Lycans-Training-27/Team-02-PADA/Mechanical/CAD/Electrical Components/ESC/LittleBee-Spring 30A.JPG

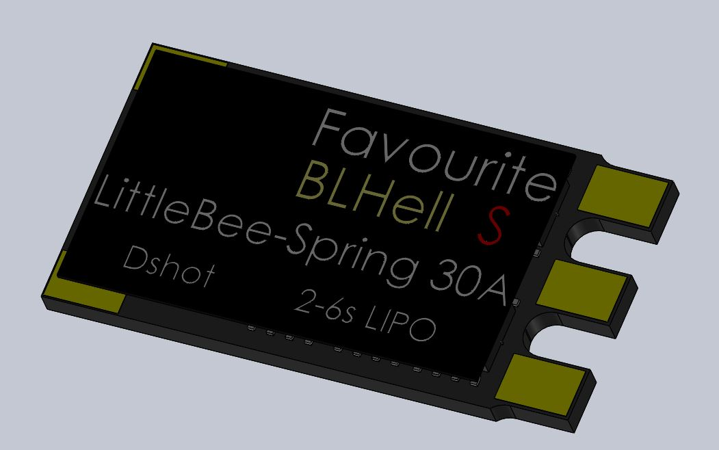
Mechanical/CAD/Electrical Components/ESC/LittleBee-Spring 30A.JPG
