Lycans-Training-27/Team-02-PADA/Mechanical/CAD/Electrical Components/Flight Controller/Автопилот Matek H743-WING V2(V3).PNG

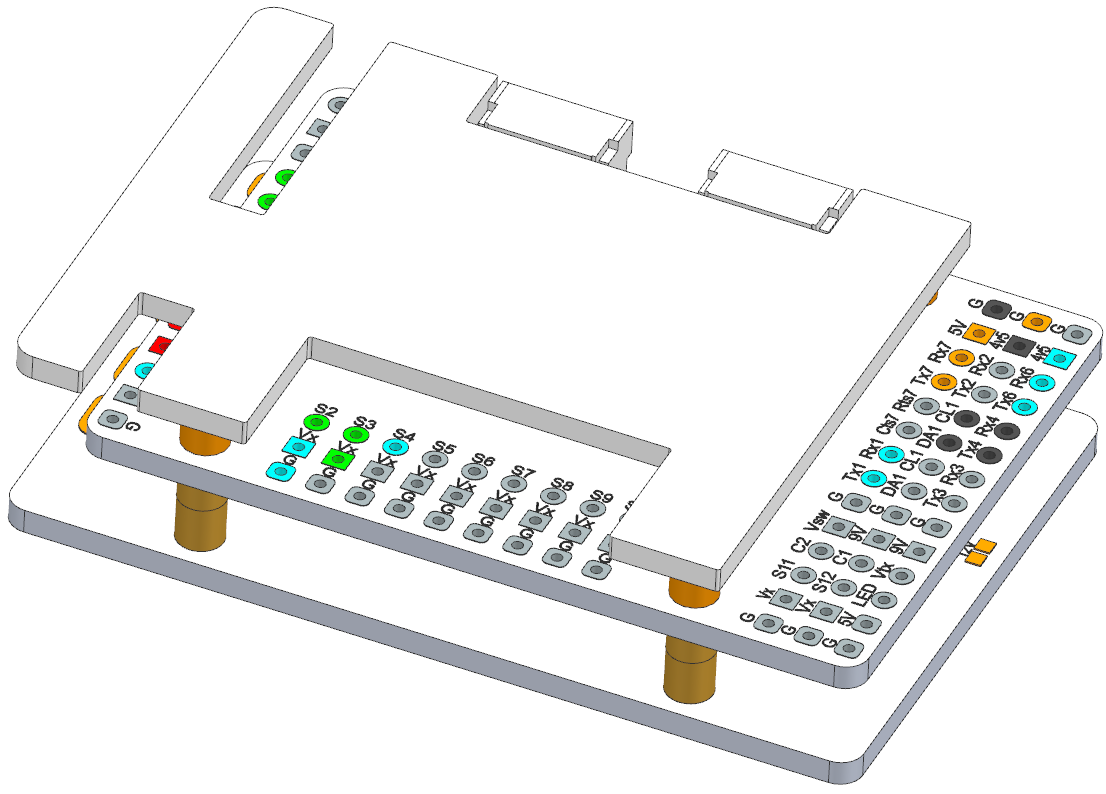
Mechanical/CAD/Electrical Components/Flight Controller/Автопилот Matek H743-WING V2(V3).PNG
