Lycans-Training-27/Team-02-PADA/Mechanical/CAD/Electrical Components/Motor/1RENDER.jpg

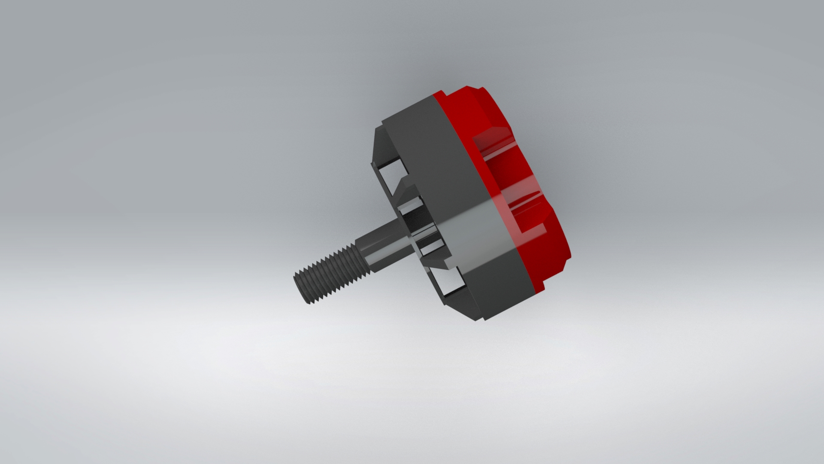
Mechanical/CAD/Electrical Components/Motor/1RENDER.jpg
