Lycans-Training-27/Team-02-PADA/Mechanical/CAD/Electrical Components/Propeller/98.jpg

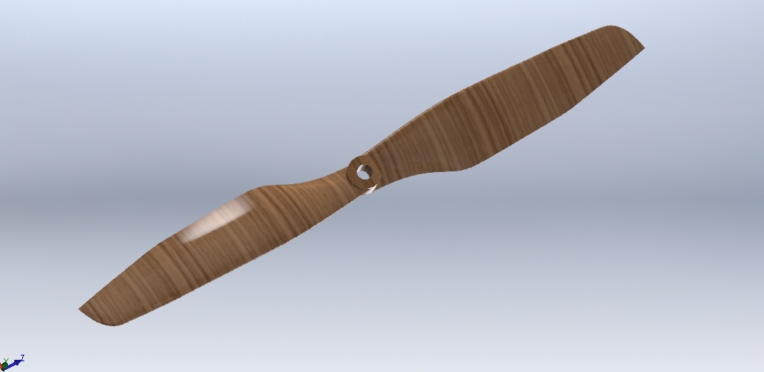
Mechanical/CAD/Electrical Components/Propeller/98.jpg
