Lycans-Training-27/Team-02-PADA/Mechanical/CAD/Electrical Components/Propeller/109.jpg

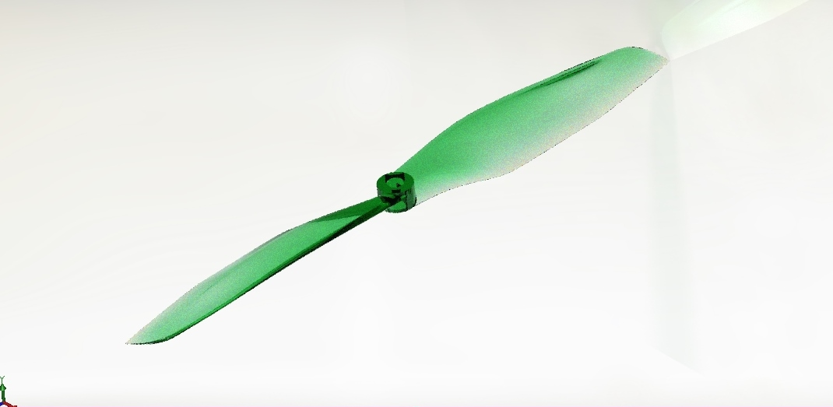
Mechanical/CAD/Electrical Components/Propeller/109.jpg
