Lycans-Training-27/Team-02-PADA/Mechanical/CAD/Electrical Components/Propeller/Renderings/8x4.5 - Rendu 2.JPG

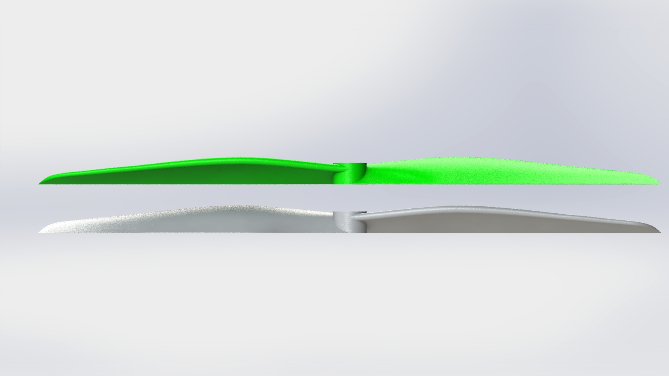
Mechanical/CAD/Electrical Components/Propeller/Renderings/8x4.5 - Rendu 2.JPG
