Lycans-Training-27/Team-02-PADA/Mechanical/CAD/Electrical Components/Propeller/Screenshot 2025-04-27 175526.png

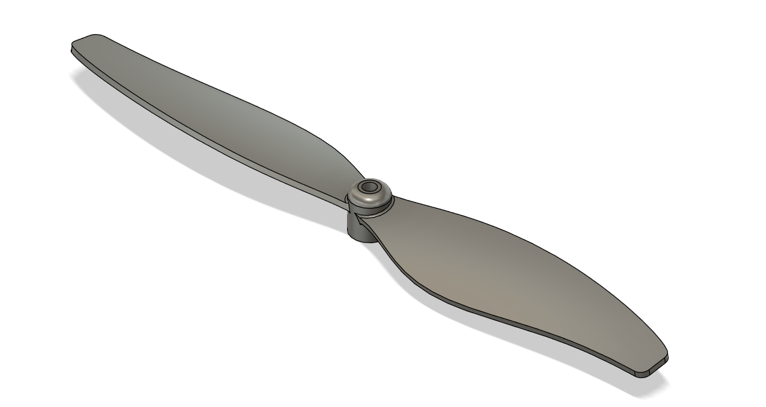
Mechanical/CAD/Electrical Components/Propeller/Screenshot 2025-04-27 175526.png
