Lycans-Training-27/Team-02-PADA/Mechanical/CAD/Electrical Components/Radio/8b44bde3-e0da-4845-a45c-0b3df0e6323b.PNG

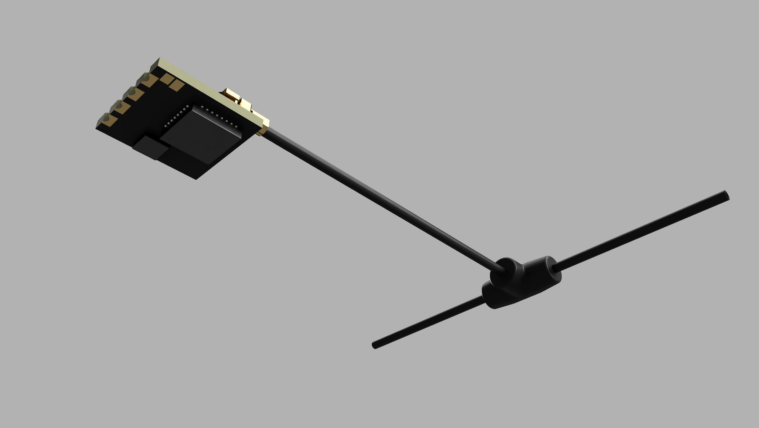
Mechanical/CAD/Electrical Components/Radio/8b44bde3-e0da-4845-a45c-0b3df0e6323b.PNG
