Lycans-Training-27/Team-02-PADA/Mechanical/CAD/Electrical Components/Radio/BetaFPV_M03_V1.1_2024-Apr-02_08-13-07AM-000_CustomizedView17843087987.png

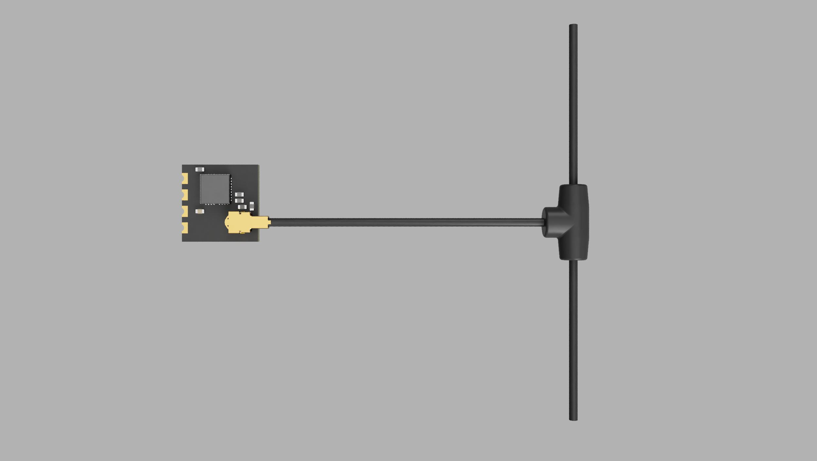
Mechanical/CAD/Electrical Components/Radio/BetaFPV_M03_V1.1_2024-Apr-02_08-13-07AM-000_CustomizedView17843087987.png
