Lycans-Training-27/Team-02-PADA/Mechanical/CAD/Electrical Components/Radio/Happymodel_EP1_Simp_2024-Apr-02_08-42-46AM-000_CustomizedView5246592539.png

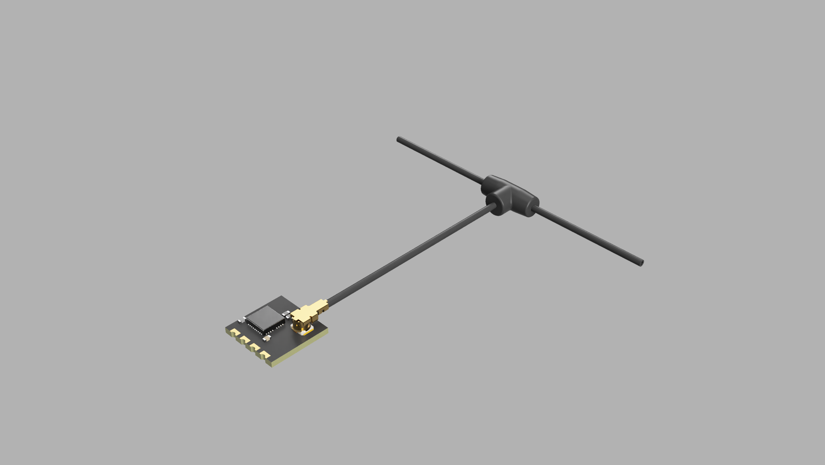
Mechanical/CAD/Electrical Components/Radio/Happymodel_EP1_Simp_2024-Apr-02_08-42-46AM-000_CustomizedView5246592539.png
