Lycans-Training-27/Team-02-PADA/Mechanical/CAD/Aircraft.SLDASM

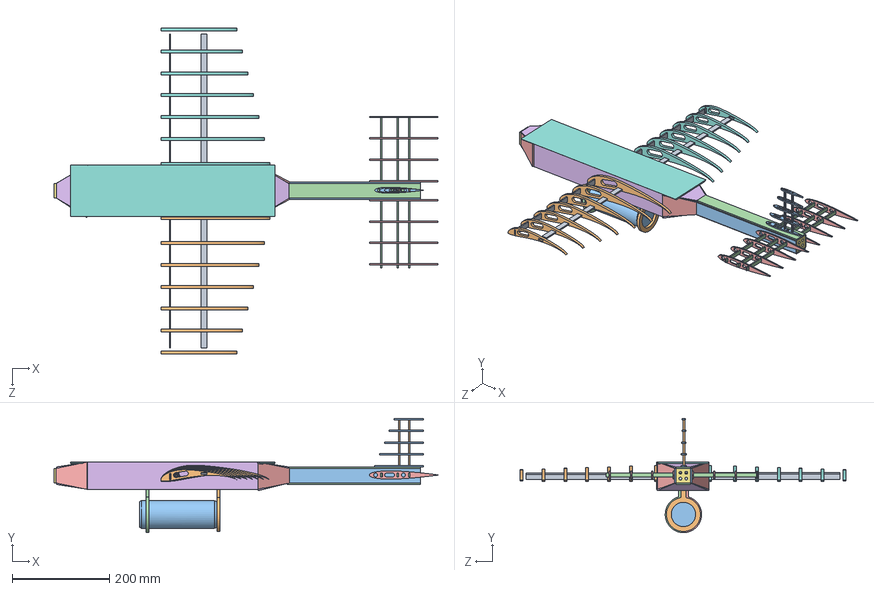
[picture p68: CAD file, 2026-09-13]
Mechanical/CAD/Aircraft.SLDASM
789.6 x 235.1 x 670.0 mm
HT
HT_Spur x 3
VT
VT_Spur x 2
Fuselage-Bulkhead x 6
Fuselage-Panel
Nose-Bulkhead x 6
Nose-Panel x 4
Nose-Panel-Side x 4
Tail-Panel x 2
Tail-Panel-Side x 2
Left-Ribs
Wing-Spar x 4
Right-Ribs
Fuselage-Panel-Right
Fuselage-Panel-Left
Fixed-Mechanism-Arm
Movable-Mechanism-Arm
Pepsi-can
Back-Support
Fuselage-Panel-Bottom
