Lycans-Training-27/Team-02-PADA/Mechanical/CAD/Aircraft+Hardware.SLDASM

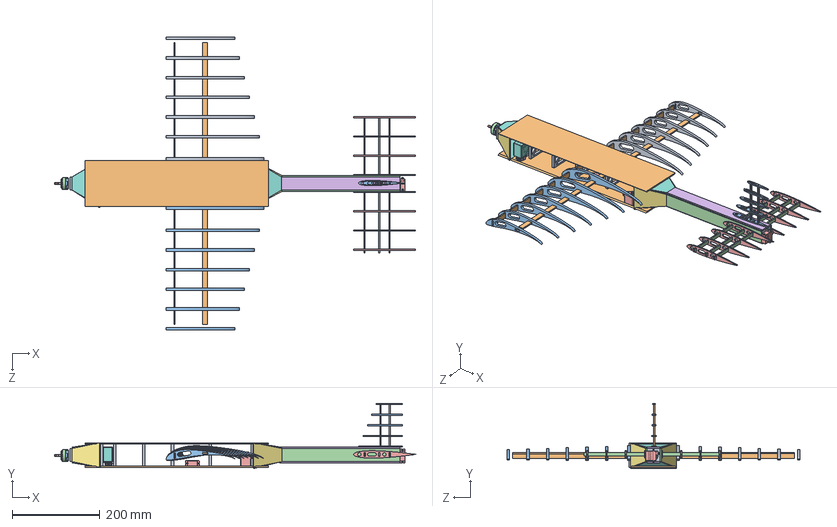
[picture p69: CAD file, 2026-09-13]
Mechanical/CAD/Aircraft+Hardware.SLDASM
825.2 x 148.9 x 670.0 mm
HT
HT_Spur x 3
VT
VT_Spur x 2
Fuselage-Bulkhead x 6
tattu 1300MHa 3s LiPo
JST XHP-4
XT60 Buchse
shaft
motor lower part
motor upper part
Fuselage-Panel x 2
Nose-Bulkhead x 6
Nose-Panel x 4
Nose-Panel-Side x 4
Tail-Panel x 2
MG90S x 5
Tail-Panel-Side x 2
Left-Ribs
Wing-Spar x 4
Right-Ribs
