Lycans-Training-27/Team-02-PADA/Mechanical/CAD/Electrical Components/Battery/TATTU 1300mah 3s.SLDASM

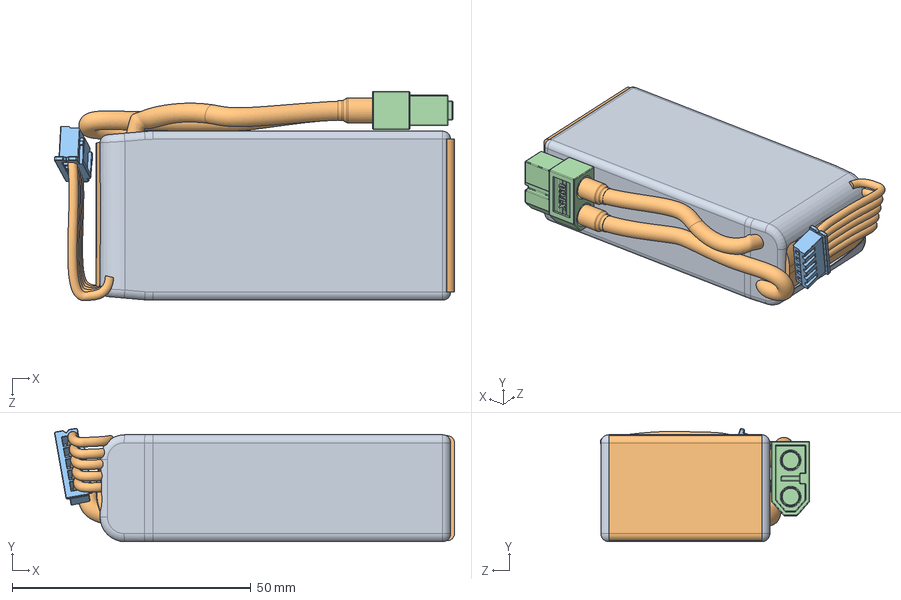
[picture p70: CAD file, 2026-09-13]
Mechanical/CAD/Electrical Components/Battery/TATTU 1300mah 3s.SLDASM
83.7 x 23.7 x 43.8 mm
tattu 1300MHa 3s LiPo
JST XHP-4
XT60 Buchse
