Lycans-Training-27/Team-02-PADA/Mechanical/CAD/Wing/Left-Wing.SLDASM

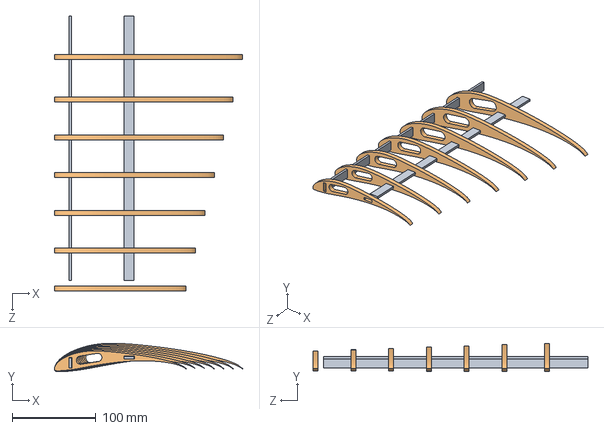
[picture p71: CAD file, 2026-09-13]
Mechanical/CAD/Wing/Left-Wing.SLDASM
224.0 x 33.8 x 327.5 mm
Left-Ribs
Wing-Spar x 2
