Lycans-Training-27/Team-02-PADA/Mechanical/CAD/Fuselage/Fuselage.SLDASM

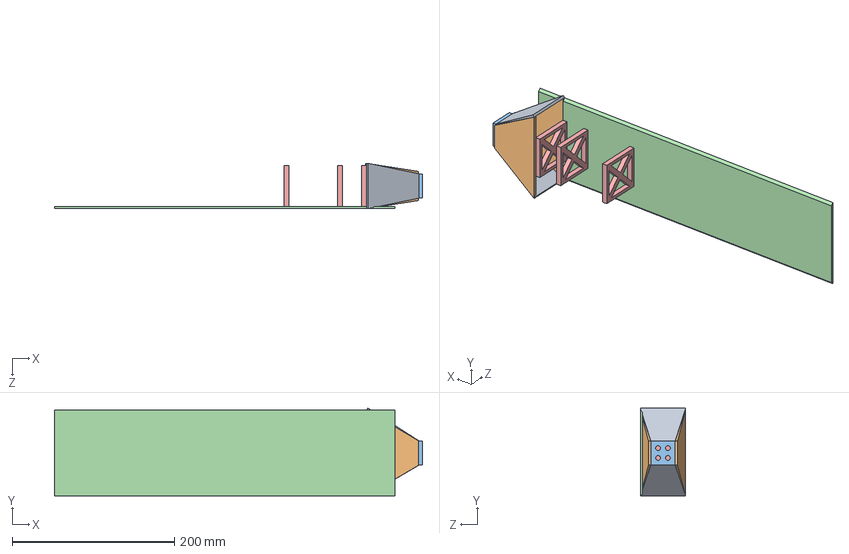
[picture p72: CAD file, 2026-09-13]
Mechanical/CAD/Fuselage/Fuselage.SLDASM
454.0 x 108.5 x 56.0 mm
Fuselage-Bulkhead x 3
Fuselage-Panel
Nose-Bulkhead
Nose-Panel x 2
Nose-Panel-Side x 2
