Lycans-Training-27/Team-02-PADA/Mechanical/CAD/Electrical Components/Battery/JST XHP-4.sldprt

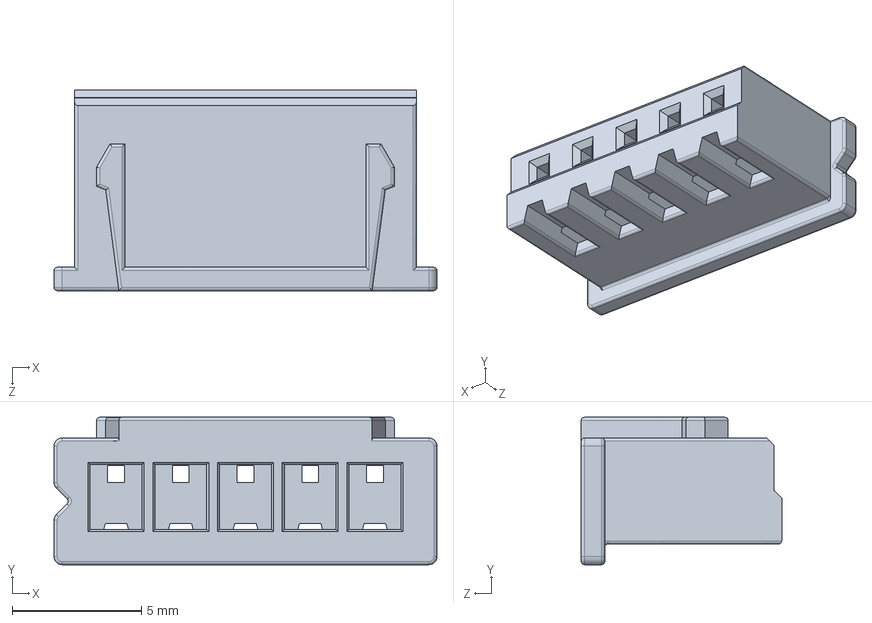
[picture p73: CAD file, 2026-09-13]
Mechanical/CAD/Electrical Components/Battery/JST XHP-4.sldprt
14.8 x 5.70 x 7.75 mm
