Lycans-Training-27/Team-02-PADA/Mechanical/CAD/Electrical Components/ESC/LittleBee-Spring30A.STEP

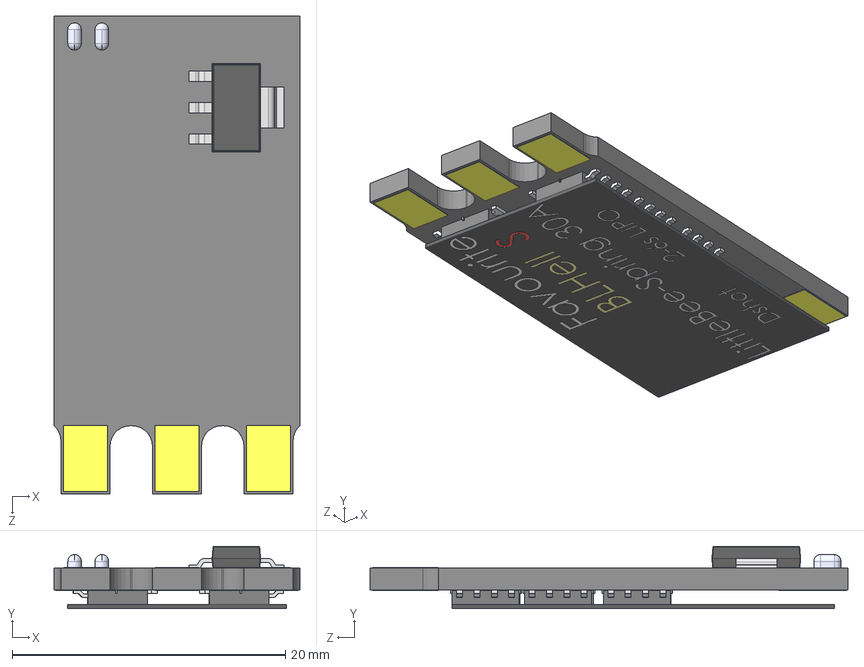
[picture p74: CAD file, 2026-09-13]
Mechanical/CAD/Electrical Components/ESC/LittleBee-Spring30A.STEP
18.0 x 4.57 x 35.0 mm
