Lycans-Training-27/Team-02-PADA/Mechanical/CAD/Electrical Components/Flight Controller/Автопилот Matek H743-WING V2(V3).stp

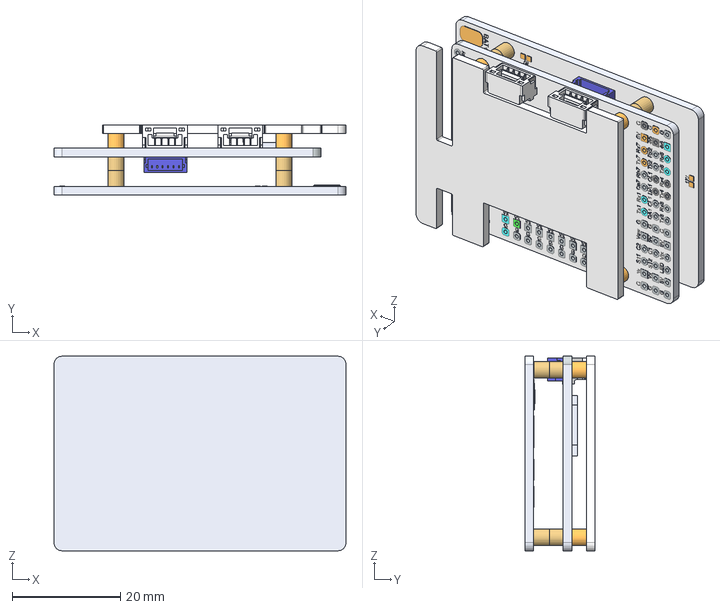
[picture p75: CAD file, 2026-09-13]
Mechanical/CAD/Electrical Components/Flight Controller/Автопилот Matek H743-WING V2(V3).stp
54.0 x 13.0 x 36.0 mm
