Lycans-Training-27/Team-02-PADA/Mechanical/CAD/Electrical Components/GPS/Mateksys M10Q-5883.step

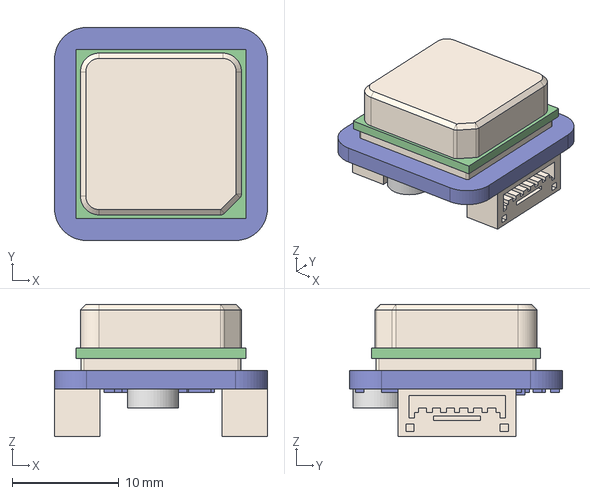
[picture p76: CAD file, 2026-09-13]
Mechanical/CAD/Electrical Components/GPS/Mateksys M10Q-5883.step
20.0 x 20.0 x 12.4 mm
