Lycans-Training-27/Team-02-PADA/Mechanical/CAD/Electrical Components/Motor/motor upper part.SLDPRT

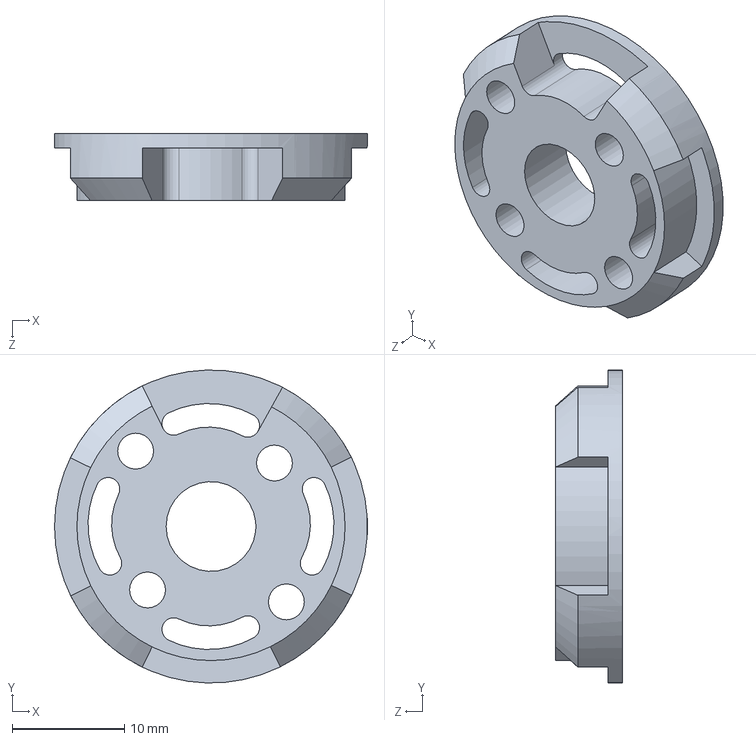
[picture p77: CAD file, 2026-09-13]
Mechanical/CAD/Electrical Components/Motor/motor upper part.SLDPRT
27.9 x 27.9 x 6.00 mm
