Lycans-Training-27/Team-02-PADA/Mechanical/CAD/Electrical Components/Propeller/Gemfan 3in 2blade.stl

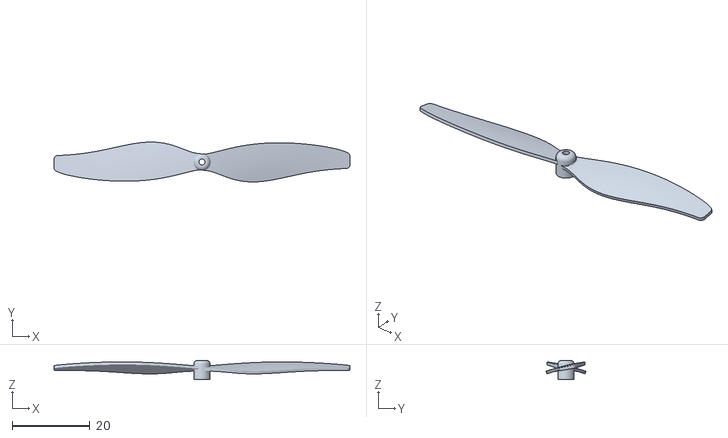
[picture p78: CAD file, 2026-09-13]
Mechanical/CAD/Electrical Components/Propeller/Gemfan 3in 2blade.stl
76.3 x 10.3 x 5.00
