Lycans-Training-27/Team-02-PADA/Mechanical/CAD/Electrical Components/Radio/Happymodel EP1 Simp.step

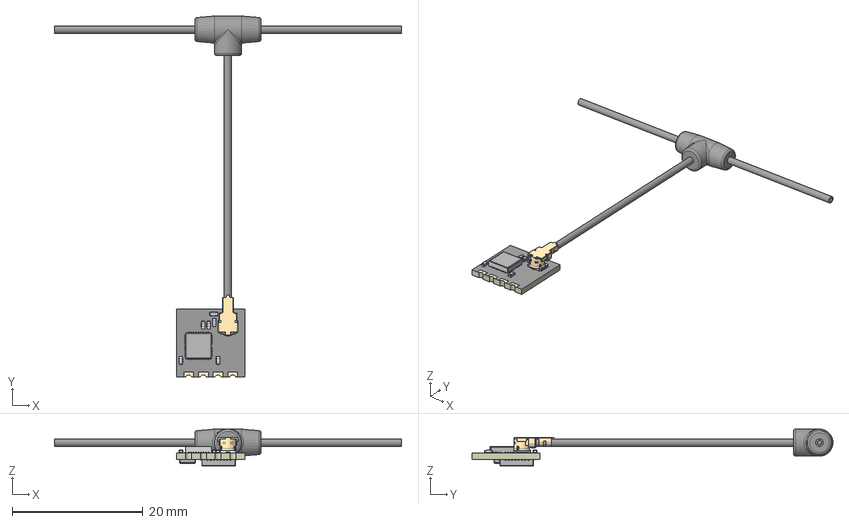
[picture p79: CAD file, 2026-09-13]
Mechanical/CAD/Electrical Components/Radio/Happymodel EP1 Simp.step
53.2 x 55.3 x 5.65 mm
Dipole T Antenna
UFL IPEX Connector v1
u.Fl Antenna Connector - 523-A-1JB v1
HM EP1
