Lycans-Training-27/Team-02-PADA/Mechanical/CAD/Electrical Components/Servo/MG90S_step.step

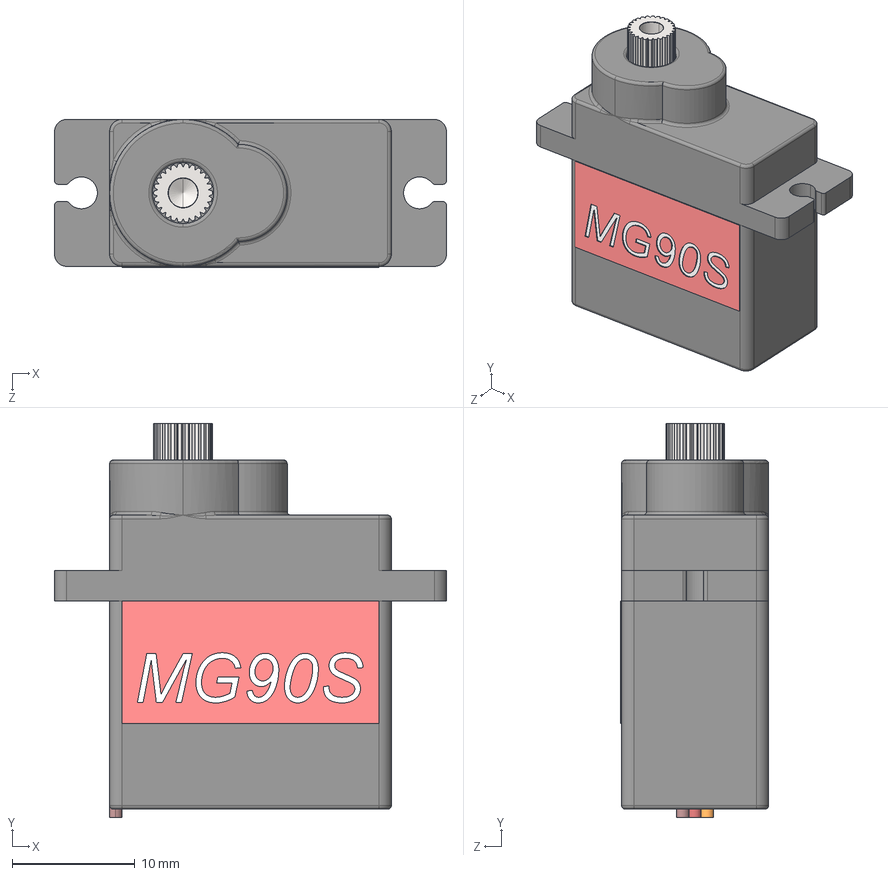
[picture p80: CAD file, 2026-09-13]
Mechanical/CAD/Electrical Components/Servo/MG90S_step.step
32.0 x 32.2 x 12.1 mm
