Lycans-Training-27/Team-02-PADA/Mechanical/CAD/Fuselage/Fuselage-Panel-Right.SLDPRT

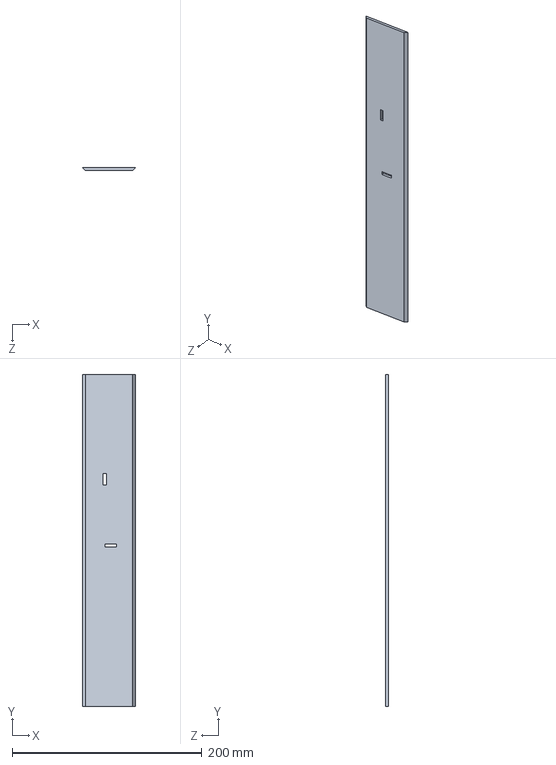
[picture p81: CAD file, 2026-09-13]
Mechanical/CAD/Fuselage/Fuselage-Panel-Right.SLDPRT
56.0 x 350.0 x 3.00 mm
