Lycans-Training-27/Team-02-PADA/Mechanical/CAD/Nose/Nose-Panel.SLDPRT

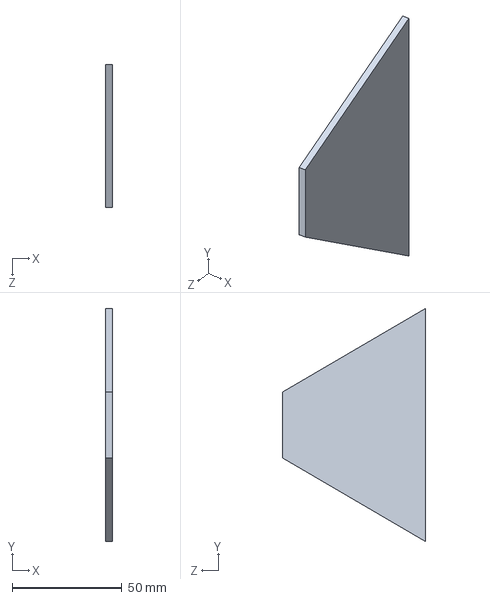
[picture p82: CAD file, 2026-09-13]
Mechanical/CAD/Nose/Nose-Panel.SLDPRT
3.00 x 106.0 x 65.0 mm
