Lycans-Training-27/Team-02-PADA/Mechanical/CAD/Release Mechanism/Movable-Mechanism-Arm.SLDPRT

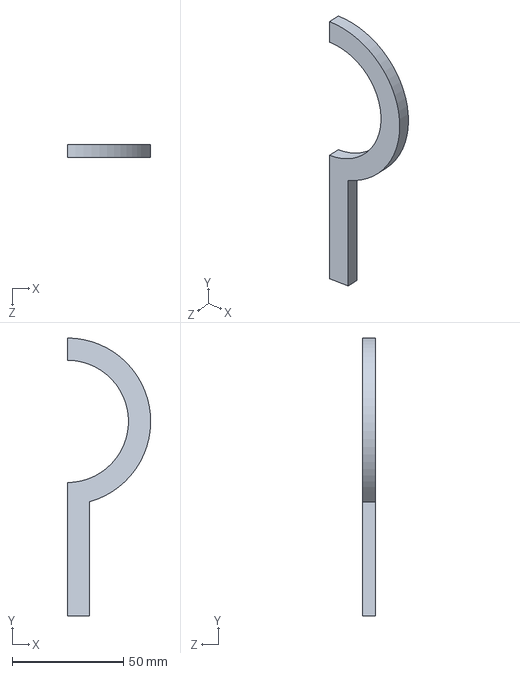
[picture p83: CAD file, 2026-09-13]
Mechanical/CAD/Release Mechanism/Movable-Mechanism-Arm.SLDPRT
37.5 x 125.0 x 6.00 mm
