Lycans-Training-27/Team-02-PADA/Mechanical/CAD/Tail/VT_Spur.SLDPRT

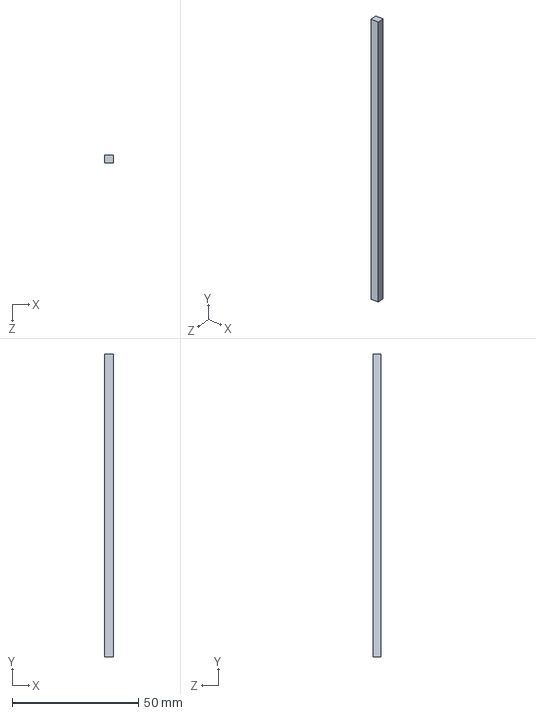
[picture p84: CAD file, 2026-09-13]
Mechanical/CAD/Tail/VT_Spur.SLDPRT
3.50 x 120.0 x 3.00 mm
