Lycans-Training-27/Team-02-PADA/Mechanical/CAD/Team2-Lycans/Fuselage-Panel-Bottom.DXF

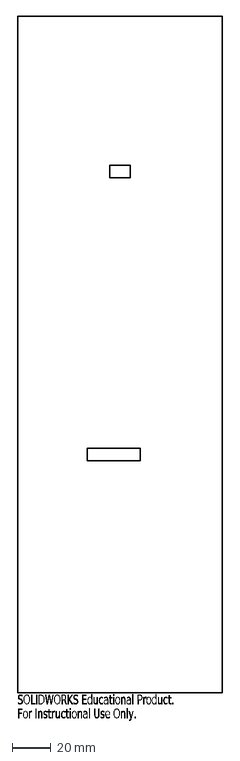
[picture p85: CAD file, 2026-09-13]
Mechanical/CAD/Team2-Lycans/Fuselage-Panel-Bottom.DXF
SOLIDWORKS Educational Product.
For Instructional Use Only.
