Lycans-Training-27/Team-02-PADA/Mechanical/CAD/Wing/Right-Ribs.SLDPRT

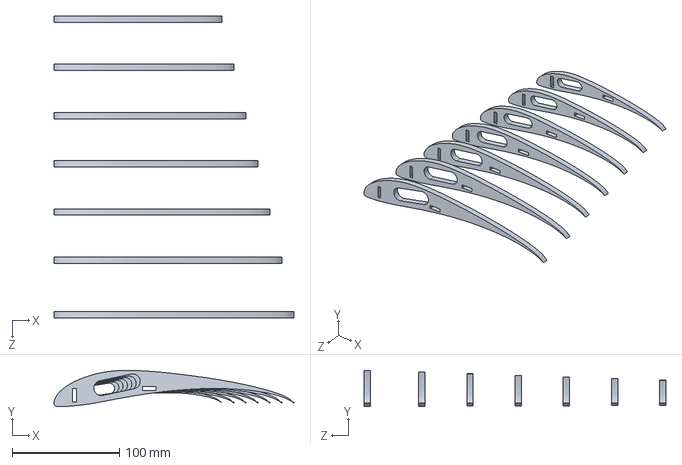
[picture p86: CAD file, 2026-09-13]
Mechanical/CAD/Wing/Right-Ribs.SLDPRT
224.0 x 33.8 x 282.0 mm
