Lycans-Training-27/Team-02-PADA/Mechanical/CAD/Electrical Components/Motor/motor lower part.SLDPRT

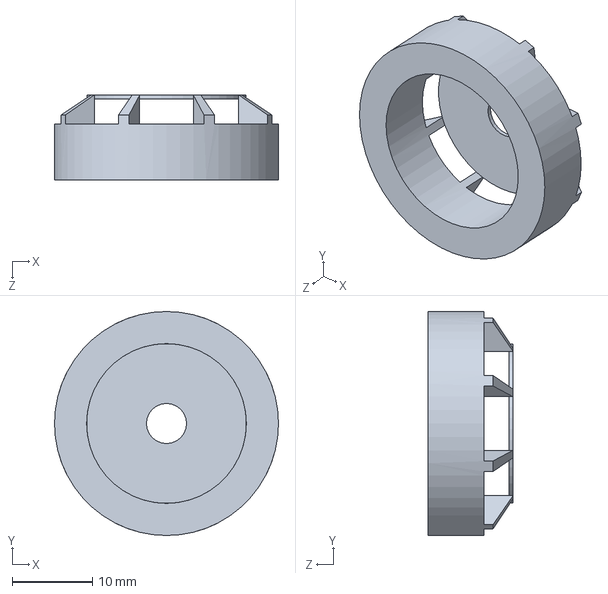
[picture p87: CAD file, 2026-09-13]
Mechanical/CAD/Electrical Components/Motor/motor lower part.SLDPRT
27.9 x 27.9 x 10.6 mm
