Lycans-Training-27/Team-02-PADA/Mechanical/CAD/Electrical Components/Propeller/PROPELLER - 8x4.5 CW.STEP

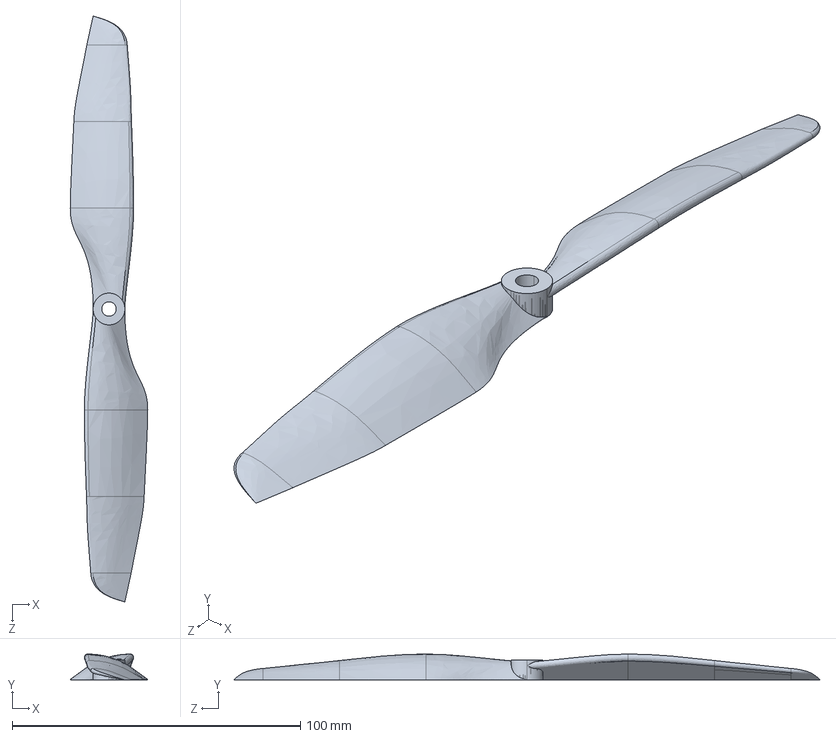
[picture p88: CAD file, 2026-09-13]
Mechanical/CAD/Electrical Components/Propeller/PROPELLER - 8x4.5 CW.STEP
26.9 x 9.01 x 203.2 mm
