Lycans-Training-27/Team-02-PADA/Mechanical/CAD/Fuselage/Fuselage-Bulkhead.SLDPRT

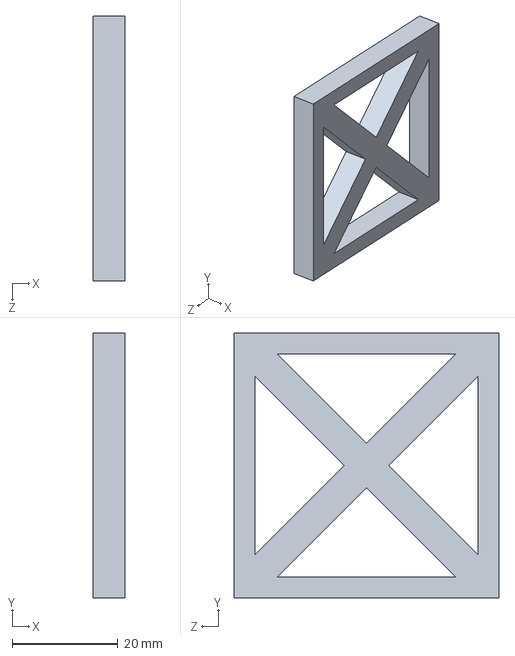
[picture p89: CAD file, 2026-09-13]
Mechanical/CAD/Fuselage/Fuselage-Bulkhead.SLDPRT
6.00 x 50.0 x 50.0 mm
