Lycans-Training-27/Team-02-PADA/Mechanical/CAD/Nose/Nose-Panel-Side.SLDPRT

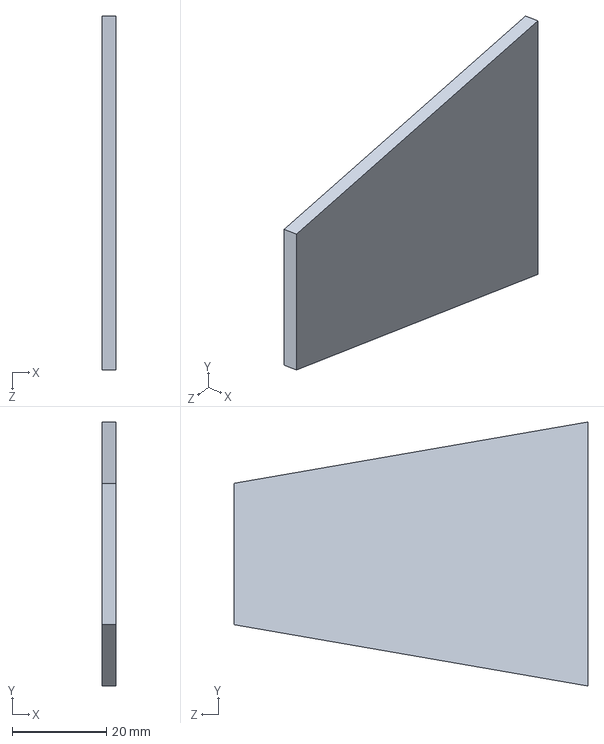
[picture p90: CAD file, 2026-09-13]
Mechanical/CAD/Nose/Nose-Panel-Side.SLDPRT
3.00 x 56.0 x 75.0 mm
