Lycans-Training-27/Team-02-PADA/Mechanical/CAD/Release Mechanism/Pepsi-can.SLDPRT

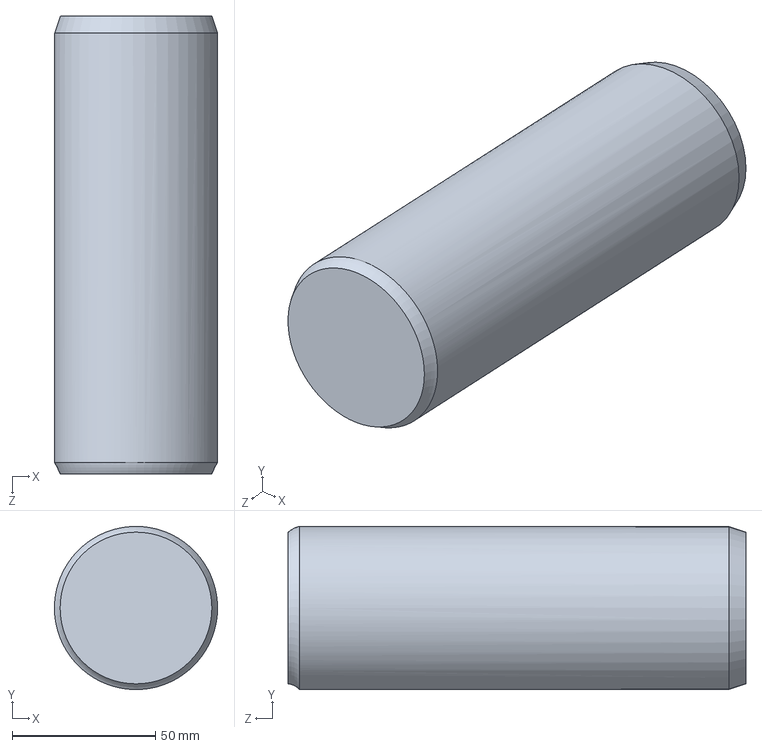
[picture p91: CAD file, 2026-09-13]
Mechanical/CAD/Release Mechanism/Pepsi-can.SLDPRT
57.0 x 57.0 x 160.0 mm
