Lycans-Training-27/Team-02-PADA/Mechanical/CAD/Tail/HT.SLDPRT

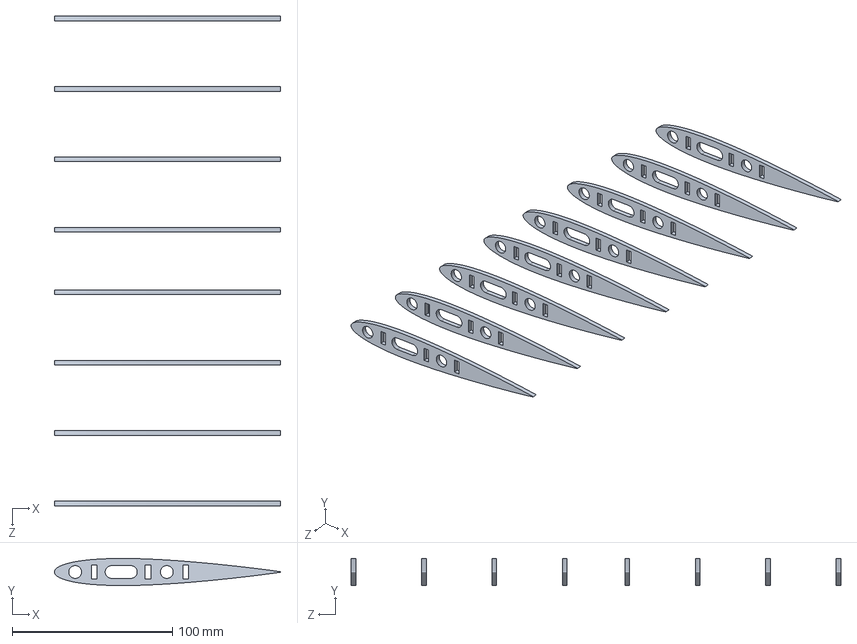
[picture p92: CAD file, 2026-09-13]
Mechanical/CAD/Tail/HT.SLDPRT
141.3 x 17.0 x 306.0 mm
