Lycans-Training-27/Team-02-PADA/Mechanical/CAD/Electrical Components/Battery/XT60 Buchse.SLDPRT

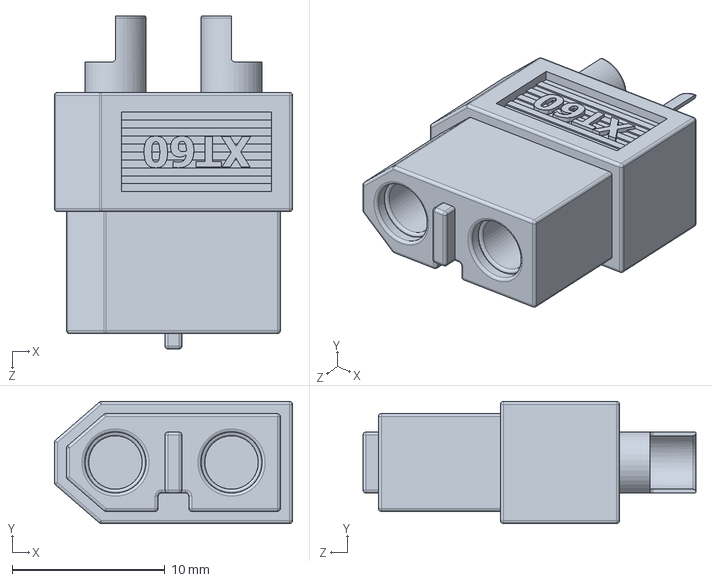
[picture p94: CAD file, 2026-09-13]
Mechanical/CAD/Electrical Components/Battery/XT60 Buchse.SLDPRT
15.6 x 8.00 x 21.8 mm
