Lycans-Training-27/Team-02-PADA/Mechanical/CAD/Electrical Components/Motor/shaft.SLDPRT

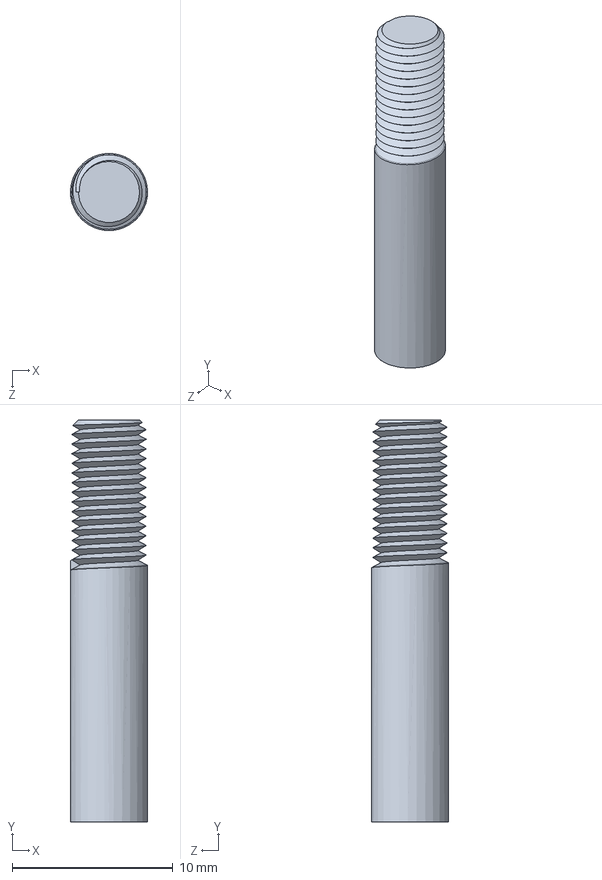
[picture p95: CAD file, 2026-09-13]
Mechanical/CAD/Electrical Components/Motor/shaft.SLDPRT
4.80 x 25.0 x 4.80 mm
