Lycans-Training-27/Team-02-PADA/Mechanical/CAD/Fuselage/Fuselage-Panel.SLDPRT

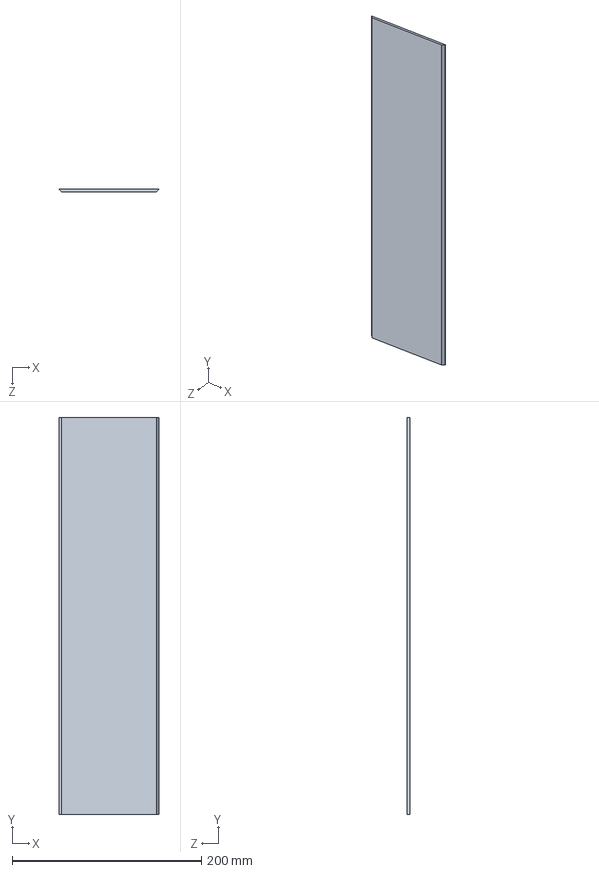
[picture p96: CAD file, 2026-09-13]
Mechanical/CAD/Fuselage/Fuselage-Panel.SLDPRT
106.0 x 420.0 x 3.00 mm
