Lycans-Training-27/Team-02-PADA/Mechanical/CAD/Nose/Nose-Bulkhead.SLDPRT

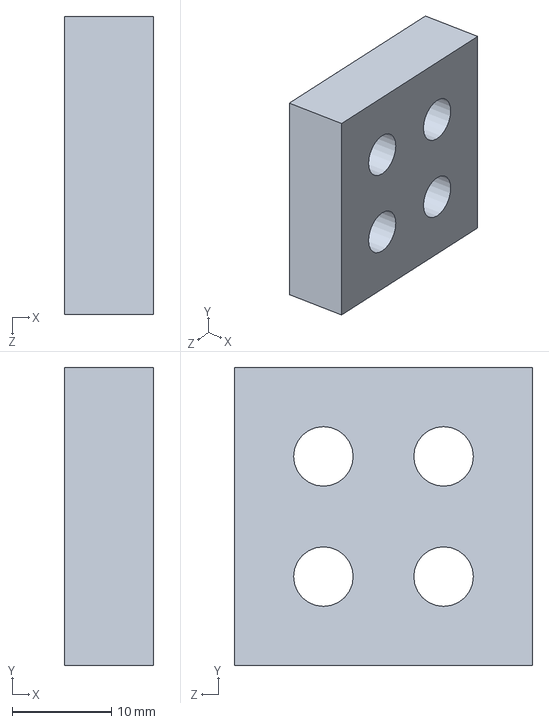
[picture p97: CAD file, 2026-09-13]
Mechanical/CAD/Nose/Nose-Bulkhead.SLDPRT
9.00 x 30.0 x 30.0 mm
