Lycans-Training-27/Team-02-PADA/Mechanical/CAD/Release Mechanism/Back-Support.SLDPRT

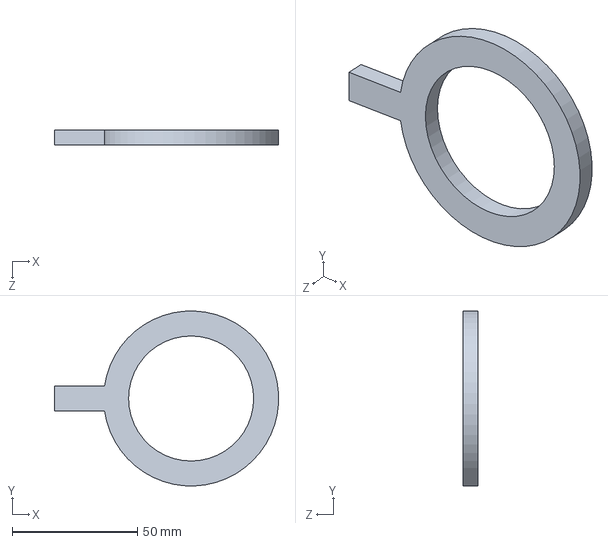
[picture p98: CAD file, 2026-09-13]
Mechanical/CAD/Release Mechanism/Back-Support.SLDPRT
89.6 x 69.9 x 6.00 mm
