Lycans-Training-27/Team-02-PADA/Mechanical/CAD/Tail/HT_Spur.SLDPRT

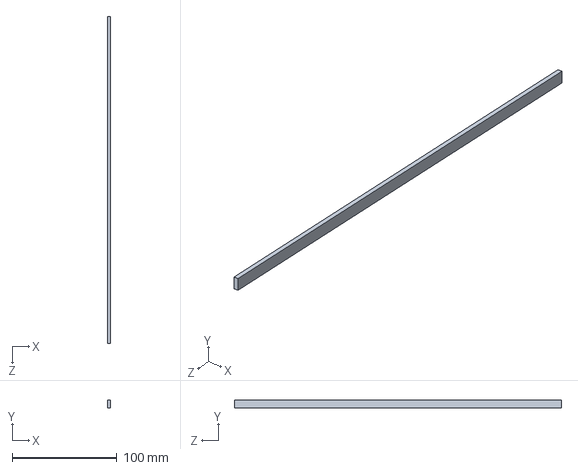
[picture p99: CAD file, 2026-09-13]
Mechanical/CAD/Tail/HT_Spur.SLDPRT
3.00 x 8.00 x 312.0 mm
