Lycans-Training-27/Team-02-PADA/Mechanical/CAD/Team2-Lycans/VT (Entity_2).DXF

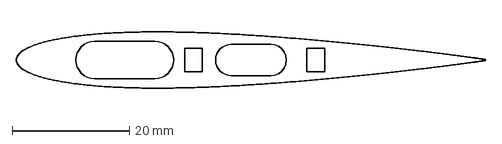
[picture p100: CAD file, 2026-09-13]
Mechanical/CAD/Team2-Lycans/VT (Entity_2).DXF
80.1 x 9.60 mm
