Lycans-Training-27/Team-02-PADA/Mechanical/CAD/Electrical Components/Battery/tattu 1300MHa 3s LiPo.SLDPRT

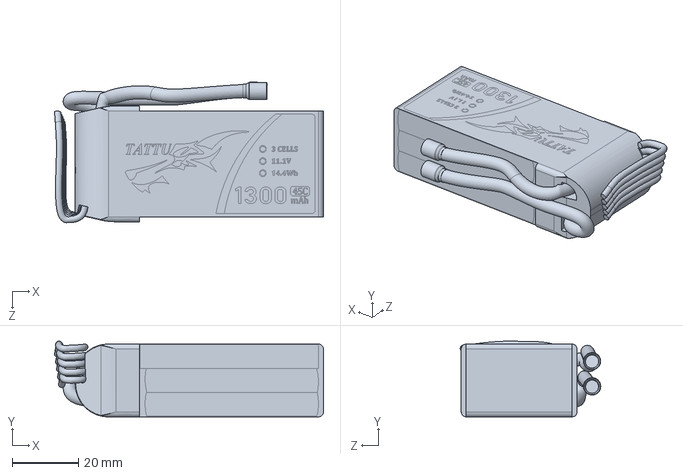
[picture p101: CAD file, 2026-09-13]
Mechanical/CAD/Electrical Components/Battery/tattu 1300MHa 3s LiPo.SLDPRT
81.3 x 22.9 x 42.5 mm
