Lycans-Training-27/Team-02-PADA/Mechanical/CAD/Electrical Components/Motor/RS2205.STEP

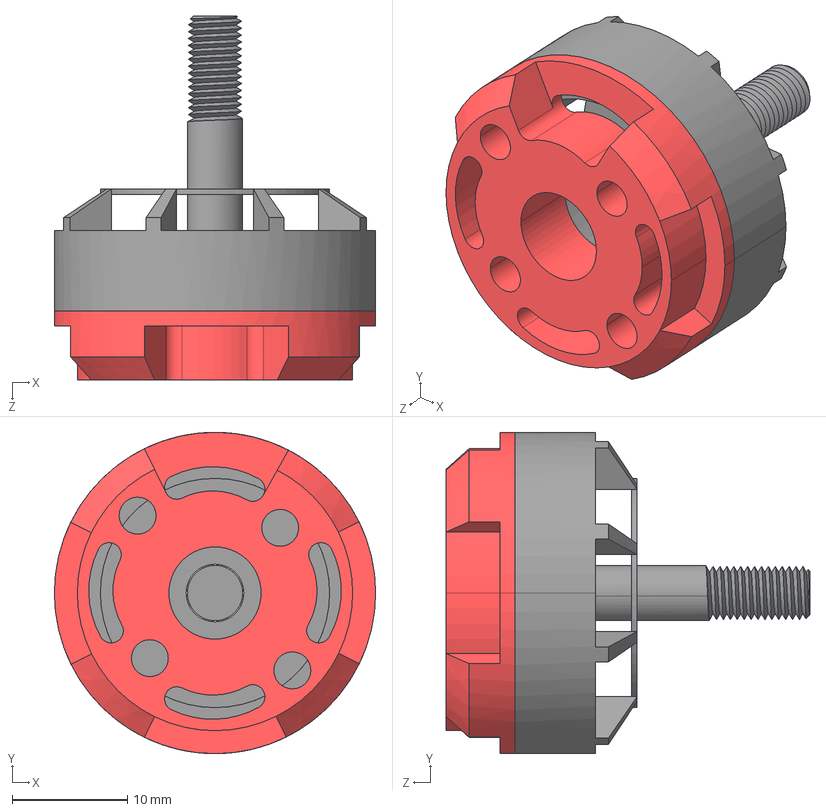
[picture p102: CAD file, 2026-09-13]
Mechanical/CAD/Electrical Components/Motor/RS2205.STEP
27.9 x 27.9 x 31.6 mm
shaft_Varsay考an
motor lower part_Varsay考an
motor upper part_Varsay考an
