Lycans-Training-27/Team-02-PADA/Mechanical/CAD/Release Mechanism/Fixed-Mechanism-Arm.SLDPRT

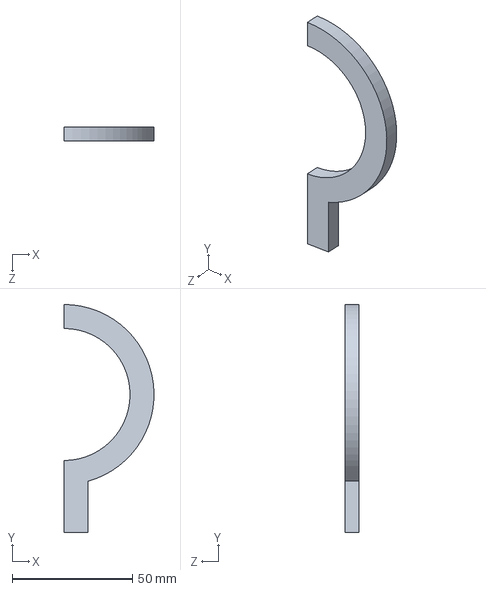
[picture p103: CAD file, 2026-09-13]
Mechanical/CAD/Release Mechanism/Fixed-Mechanism-Arm.SLDPRT
37.5 x 95.0 x 6.00 mm
