Lycans-Training-27/Team-02-PADA/Mechanical/CAD/Tail/VT.SLDPRT

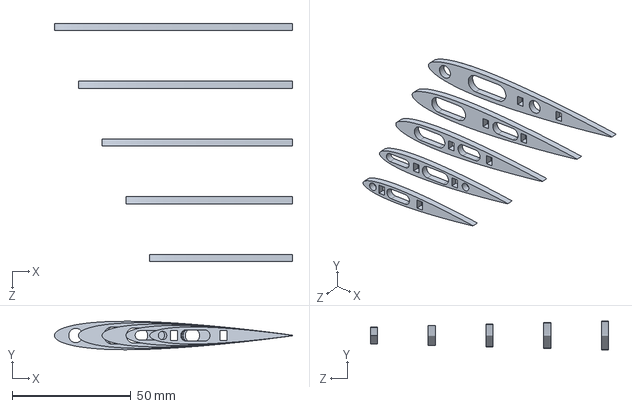
[picture p104: CAD file, 2026-09-13]
Mechanical/CAD/Tail/VT.SLDPRT
100.1 x 12.0 x 100.0 mm
