Lycans-Training-27/Team-02-PADA/Mechanical/CAD/Team2-Lycans/VT (Entity_1).DXF

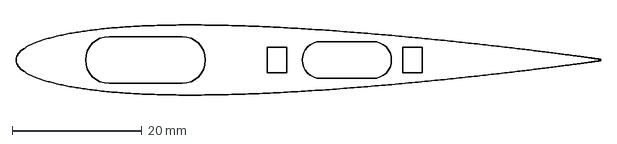
[picture p105: CAD file, 2026-09-13]
Mechanical/CAD/Team2-Lycans/VT (Entity_1).DXF
90.1 x 10.8 mm
