Lycans-Training-27/Team-02-PADA/Mechanical/CAD/Wing/Wing-Spar.SLDPRT

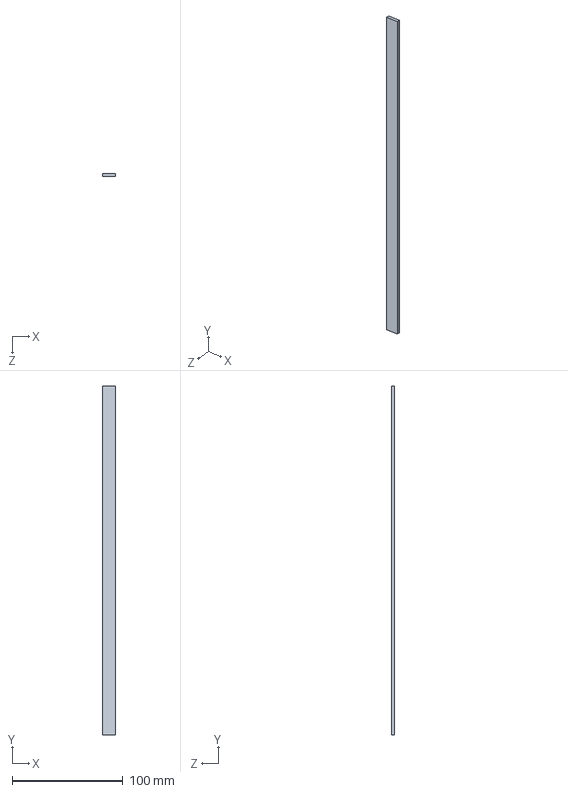
[picture p106: CAD file, 2026-09-13]
Mechanical/CAD/Wing/Wing-Spar.SLDPRT
12.0 x 315.0 x 3.00 mm
