Lycans-Training-27/Team-02-PADA/Mechanical/CAD/Electrical Components/Battery/FUNDA 13.SLDPRT

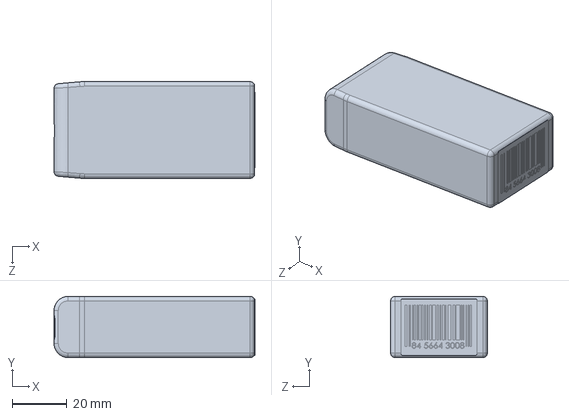
[picture p107: CAD file, 2026-09-13]
Mechanical/CAD/Electrical Components/Battery/FUNDA 13.SLDPRT
73.5 x 22.4 x 35.4 mm
