Lycans-Training-27/Team-02-PADA/Mechanical/CAD/Tail/Tail-Panel-Side.SLDPRT

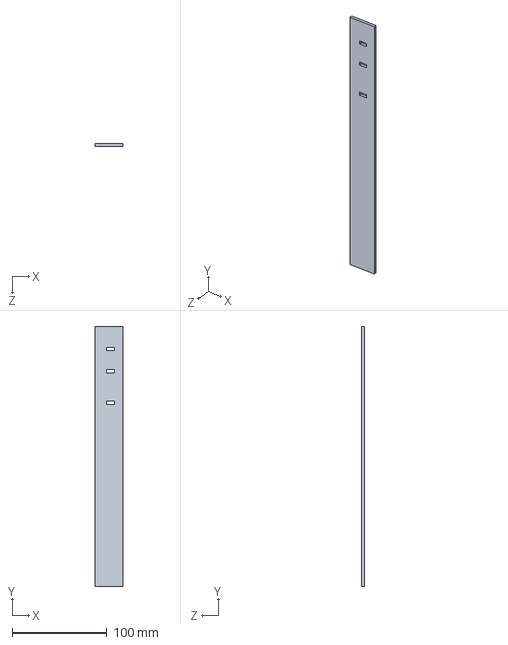
[picture p108: CAD file, 2026-09-13]
Mechanical/CAD/Tail/Tail-Panel-Side.SLDPRT
30.0 x 275.0 x 3.00 mm
