Lycans-Training-27/Team-02-PADA/Mechanical/CAD/Team2-Lycans/Left-Ribs (Entity_5).DXF

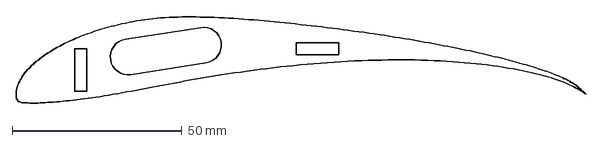
[picture p109: CAD file, 2026-09-13]
Mechanical/CAD/Team2-Lycans/Left-Ribs (Entity_5).DXF
168.0 x 25.4 mm
