Lycans-Training-27/Team-02-PADA/Mechanical/CAD/Team2-Lycans/Tail-Panel-Side.DXF

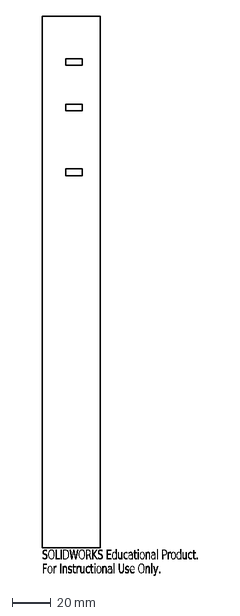
[picture p110: CAD file, 2026-09-13]
Mechanical/CAD/Team2-Lycans/Tail-Panel-Side.DXF
SOLIDWORKS Educational Product.
For Instructional Use Only.
