Lycans-Training-27/Team-02-PADA/Mechanical/CAD/Team2-Lycans/Left-Ribs (Entity_3).DXF

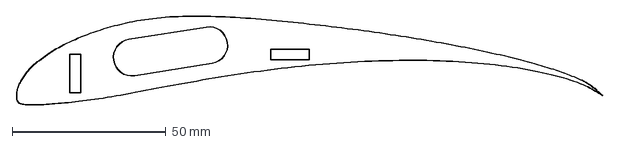
[picture p111: CAD file, 2026-09-13]
Mechanical/CAD/Team2-Lycans/Left-Ribs (Entity_3).DXF
190.4 x 28.8 mm
