Lycans-Training-27/Team-02-PADA/Mechanical/CAD/Team2-Lycans/Movable-Mechanism-Arm.DXF

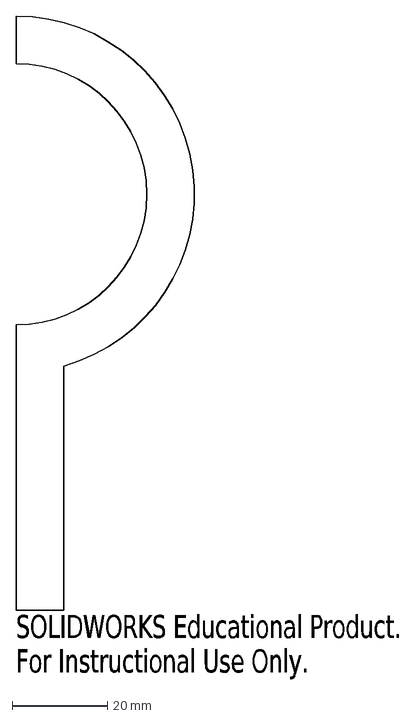
[picture p113: CAD file, 2026-09-13]
Mechanical/CAD/Team2-Lycans/Movable-Mechanism-Arm.DXF
SOLIDWORKS Educational Product.
For Instructional Use Only.
