Lycans-Training-27/Team-02-PADA/Mechanical/CAD/Team2-Lycans/VT_Spur.DXF

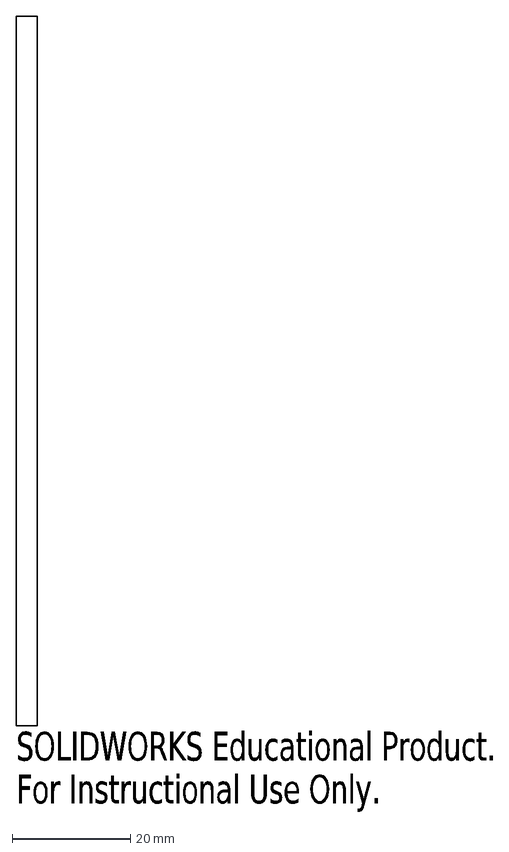
[picture p115: CAD file, 2026-09-13]
Mechanical/CAD/Team2-Lycans/VT_Spur.DXF
SOLIDWORKS Educational Product.
For Instructional Use Only.
