Lycans-Training-27/Team-02-PADA/Mechanical/CAD/Team2-Lycans/VT (Entity_4).DXF

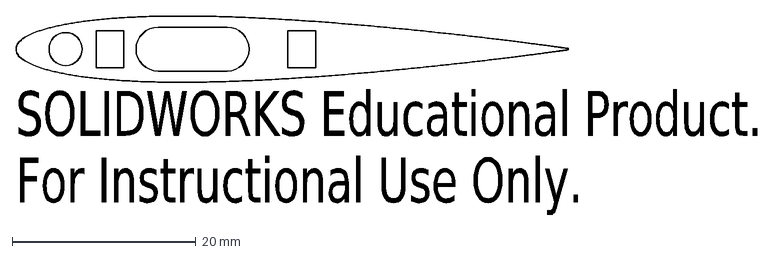
[picture p116: CAD file, 2026-09-13]
Mechanical/CAD/Team2-Lycans/VT (Entity_4).DXF
SOLIDWORKS Educational Product.
For Instructional Use Only.
