Lycans-Training-27/Team-02-PADA/Mechanical/CAD/Team2-Lycans/Left-Ribs (Entity_0).DXF

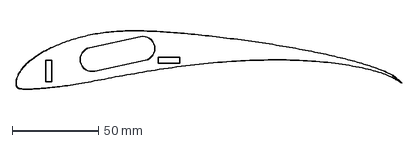
[picture p117: CAD file, 2026-09-13]
Mechanical/CAD/Team2-Lycans/Left-Ribs (Entity_0).DXF
224.0 x 33.9 mm
