Lycans-Training-27/Team-02-PADA/Mechanical/CAD/Team2-Lycans/Nose-Bulkhead.DXF

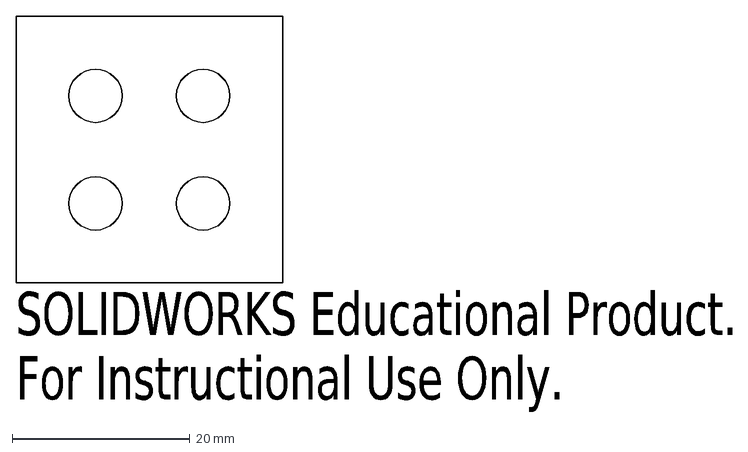
[picture p118: CAD file, 2026-09-13]
Mechanical/CAD/Team2-Lycans/Nose-Bulkhead.DXF
SOLIDWORKS Educational Product.
For Instructional Use Only.
