Lycans-Training-27/Team-02-PADA/Mechanical/CAD/Team2-Lycans/Tail-Panel.DXF

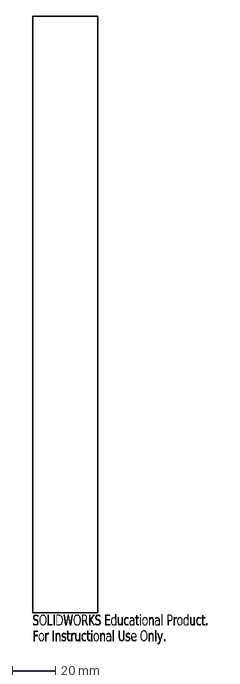
[picture p119: CAD file, 2026-09-13]
Mechanical/CAD/Team2-Lycans/Tail-Panel.DXF
SOLIDWORKS Educational Product.
For Instructional Use Only.
