Lycans-Training-27/Team-02-PADA/Mechanical/CAD/Team2-Lycans/Left-Ribs (Entity_6).DXF

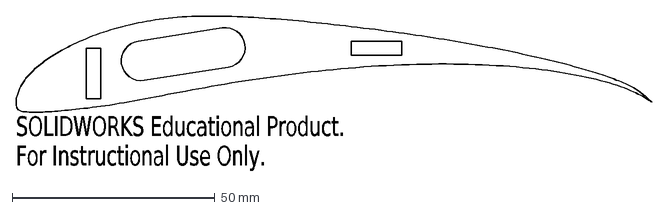
[picture p120: CAD file, 2026-09-13]
Mechanical/CAD/Team2-Lycans/Left-Ribs (Entity_6).DXF
SOLIDWORKS Educational Product.
For Instructional Use Only.
