Lycans-Training-27/Team-02-PADA/Mechanical/CAD/Team2-Lycans/Fixed-Mechanism-Arm.DXF

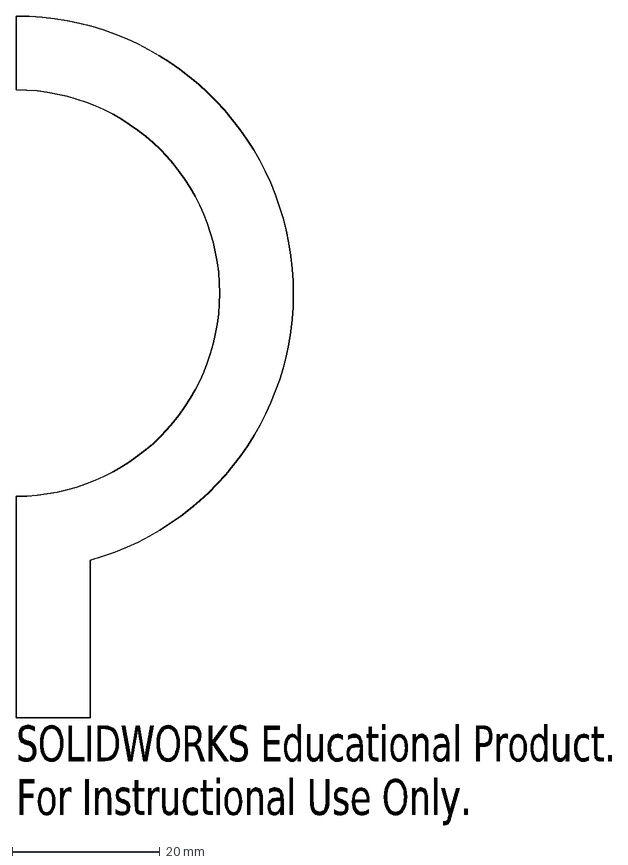
[picture p122: CAD file, 2026-09-13]
Mechanical/CAD/Team2-Lycans/Fixed-Mechanism-Arm.DXF
SOLIDWORKS Educational Product.
For Instructional Use Only.
