Lycans-Training-27/Team-02-PADA/Mechanical/CAD/Team2-Lycans/VT (Entity_3).DXF

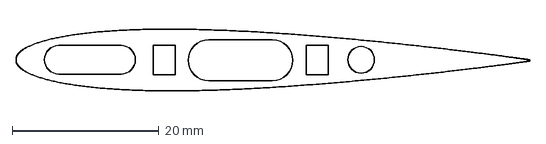
[picture p123: CAD file, 2026-09-13]
Mechanical/CAD/Team2-Lycans/VT (Entity_3).DXF
70.1 x 8.40 mm
