Lycans-Training-27/Team-02-PADA/Mechanical/CAD/Team2-Lycans/Nose-Panel.DXF

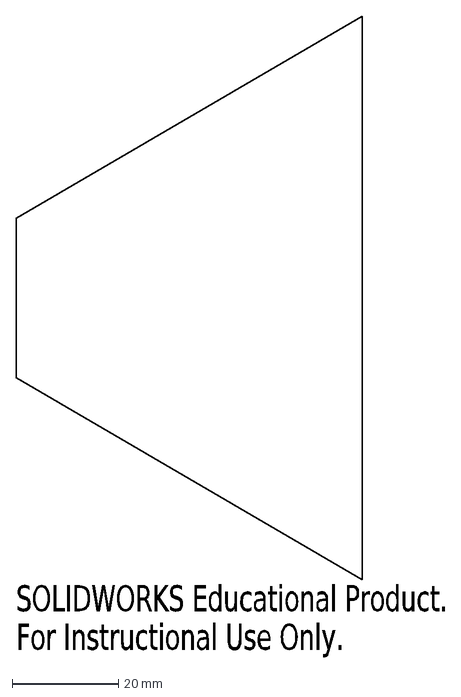
[picture p124: CAD file, 2026-09-13]
Mechanical/CAD/Team2-Lycans/Nose-Panel.DXF
SOLIDWORKS Educational Product.
For Instructional Use Only.
