Lycans-Training-27/Team-02-PADA/Mechanical/CAD/Team2-Lycans/Left-Ribs (Entity_2).DXF

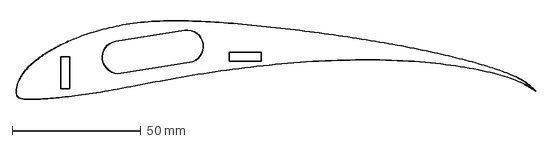
[picture p125: CAD file, 2026-09-13]
Mechanical/CAD/Team2-Lycans/Left-Ribs (Entity_2).DXF
201.6 x 30.5 mm
