Lycans-Training-27/Team-02-PADA/Mechanical/CAD/Team2-Lycans/Back-Support.DXF

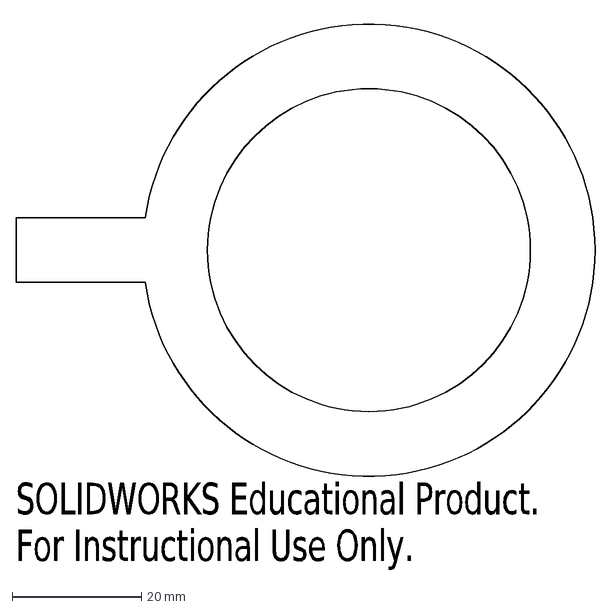
[picture p126: CAD file, 2026-09-13]
Mechanical/CAD/Team2-Lycans/Back-Support.DXF
SOLIDWORKS Educational Product.
For Instructional Use Only.
