Lycans-Training-27/Team-02-PADA/Mechanical/CAD/Team2-Lycans/VT (Entity_0).DXF

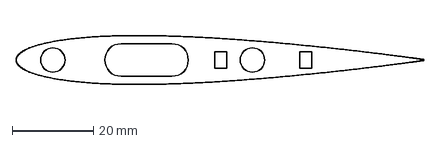
[picture p129: CAD file, 2026-09-13]
Mechanical/CAD/Team2-Lycans/VT (Entity_0).DXF
100.1 x 12.0 mm
