Lycans-Training-27/Team-02-PADA/(list of files, cad)

Other CAD files:
Mechanical/CAD/Wing/Right-Wing.SLDASM
Mechanical/Manufacturing/AUTOCAD 2D Lazer Construction.dwg
Mechanical/CAD/Electrical Components/GPS/Mateksys M10Q-5883 v6.iges
Mechanical/CAD/Electrical Components/Servo/MG90S.SLDPRT
Mechanical/CAD/Electrical Components/Propeller/PROPELLER - 8x4.5 CCW.STEP
Mechanical/CAD/Wing/Left-Ribs.SLDPRT
Mechanical/CAD/Fuselage/Fuselage-Panel-Bottom.SLDPRT
Mechanical/CAD/Fuselage/Fuselage-Panel-Side.SLDPRT
Mechanical/CAD/Fuselage/Fuselage-Panel-Left.SLDPRT
Mechanical/CAD/Tail/Tail-Panel.SLDPRT
Mechanical/CAD/Electrical Components/ESC/LittleBee-Spring30A.SLDPRT
Mechanical/CAD/Electrical Components/GPS/Mateksys M10Q-5883 v6.3mf
Mechanical/CAD/Electrical Components/GPS/Mateksys M10Q-5883 v6.f3d
Mechanical/CAD/Electrical Components/Motor/RS2205.SLDASM
Mechanical/CAD/Electrical Components/Propeller/PROPELLER - 8x4.5 CCW.sldprt
Mechanical/CAD/Electrical Components/Propeller/PROPELLER - 8x4.5 CW.sldprt
