Lycans-Training-27/Team-02-PADA/Mechanical/CAD/Electrical Components/Servo/mg90s_step.JPG

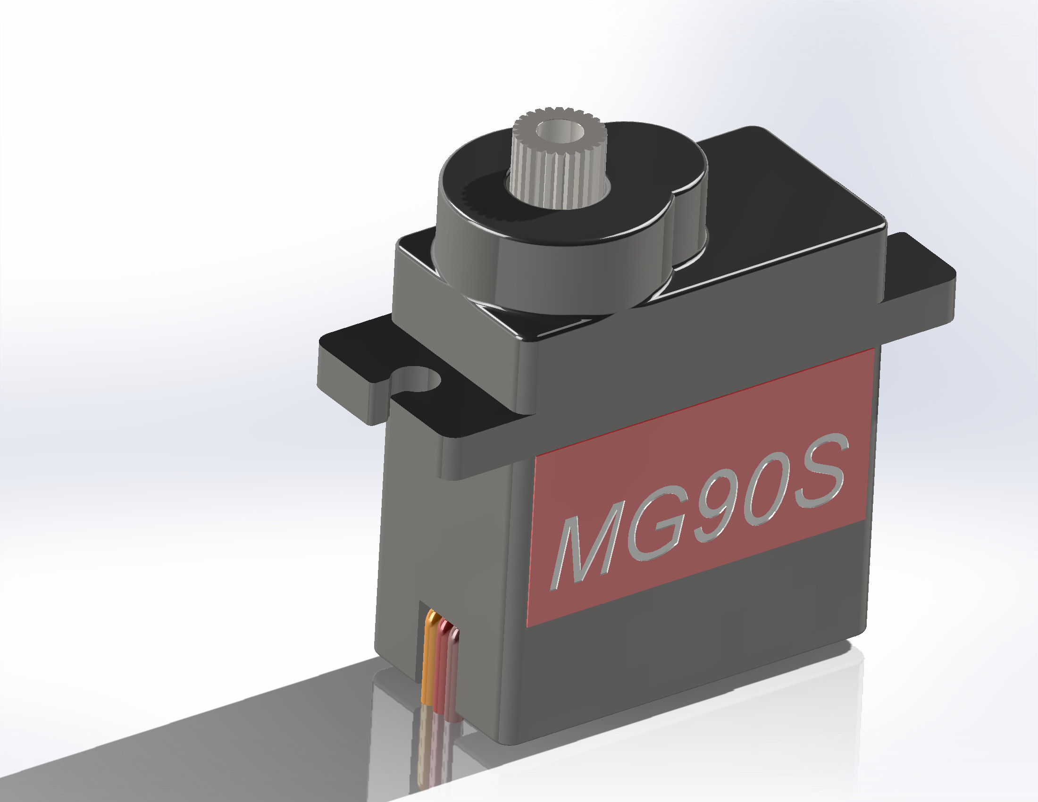
Mechanical/CAD/Electrical Components/Servo/mg90s_step.JPG
