Lycans-Training-27/Team-02-PADA/(commit log)

2026-09-13 added mechanical files
    [AUTOCAD 2D Lazer Construction.dwg, Aircraft+Hardware.SLDASM, Aircraft.SLDASM, AirfoilTrade Study.xlsx, Back-Support.DXF, Back-Support.SLDPRT, FUNDA 13.SLDPRT, Fixed-Mechanism-Arm.DXF]
2026-09-13 Full technical Report
    [AUTOCAD 2D Lazer Construction.dwg]
